TektiteBiz/Tektite-R_EV_Template/README.md

# Tektite-R Electric Vehicle Science Kit
This repository houses the source code and design files for the Tektite-R electric vehicle science kit!

Image of the kit

You can purchase the kit at [our online store](https://tektitebiz.com/product/tektite-r-electric-vehicle-science-kit/).

Find the price analysis and PCB/Schematic files in the Design folder of this repository.

The CAD is on Onshape [here](https://cad.onshape.com/documents/a678383564e9312296f3020b/w/27c2249d7c4797c00d9de45e/e/83639f3ea8453a739e7286b1).
