TektiteBiz/Tektite-R_EV_Template/Design/Pricing.xlsx

Item | Link | Cost | Quantity | Total Cost | Note | Final price--> | $103.91
Black PLA (Frame) | https://www.amazon.com/dp/B0BV24T11D/ | $52.80 | 0.02 | $1.28
ESC (35A XT60) | https://www.aliexpress.us/item/3256806557891003.html | $18.30 | 1.00 | $18.30 | Alternate: https://www.aliexpress.us/item/3256805329452853.html
8x Battery holder | https://www.amazon.com/dp/B07KVHMQRH | $9.34 | 0.50 | $4.67
BaneBots Wheels | https://banebots.com/banebots-wheel-2-x-0-8-hub-mount-40a-orange/ | $74.80 | 0.20 | $14.96
Central shaft (5mm diameter, 100mm long) | https://www.aliexpress.us/item/3256806106856975.html | $0.88 | 1.00 | $0.88
Wheel D shaft (5x138mm) | https://www.aliexpress.us/item/3256806188242363.html | $3.45 | 2.00 | $6.89
Motor (1000kv) | https://www.aliexpress.us/item/2251832679959065.html | $10.05 | 1.00 | $10.05 | The 5.26 in the cost is shipping, but that is once per order
Motor pulley | https://www.aliexpress.us/item/3256805934638435.html | $2.18 | 1.00 | $2.18 | Alternate: https://www.aliexpress.us/item/3256803888885845.html
Long belt pulleys (20T5-60T5, 2GT-280-6) | https://www.aliexpress.us/item/3256804652854836.html | $3.90 | 2.00 | $7.80 | Alternate: https://www.aliexpress.us/item/3256807041239789.html
Short belt pulley (20T5-60T5, 2GT-158-6) | https://www.aliexpress.us/item/3256804652854836.html | $3.81 | 1.00 | $3.81 | Alternate: https://www.aliexpress.us/item/3256802203384432.html and https://www.aliexpress.us/item/2251832693571771.html
Bearing | https://www.aliexpress.us/item/3256806307993875.html | $5.16 | 0.60 | $3.10 | Need 6 bearing, comes in lot of 10, Alternate: https://www.aliexpress.us/item/3256805156145762.html
Quadrature encoder | https://www.aliexpress.us/item/3256804193376739.html | $5.53 | 1.00 | $5.53
Encoder JST connector (PH 2mm, 4P) + Heatshrink | https://www.aliexpress.us/item/3256804650896588.html | $3.03 | 0.20 | $0.61 | Comes in pack of 5
Short screw (M3x6mmm) | https://www.amazon.com/dp/B012TE12CY | $6.59 | 0.17 | $1.12 | Need 17/100 screws
MP screw (M3x12mm) | https://www.amazon.com/dp/B07MHNXPJL | $9.57 | 0.02 | $0.19 | Need 2/100 screws
Button caps | https://www.aliexpress.us/item/2251832666419248.html | $ 5.71 | 0.02 | $ 0.11
Wheel screw (M3x16mm) | https://www.amazon.com/dp/B01BBOZ4JA/ | $8.17 | 0.04 | $0.33 | Need 4/100 screws
Laser pointer | https://www.amazon.com/gp/product/B09NHK7GX9 | $13.19 | 0.17 | $2.20 | Need 1/6 laser pointers
NiCD batteries | https://www.amazon.com/gp/product/B07SG43L9Q/ | $8.80 | 0.00 | $0.00 | NOT INCLUDED WITH KIT
PCB | https://jlcpcb.com | $200.29 | 0.10 | $20.03 | Getting 1 of the 10 in the JLCPCB order
Thank You note | N/A | $0.00 | 1.00 | $0.00
