TektiteBiz/Tektite-R_EV_Template/Design/PCB/BOM_Tektite-R_2024-08-30.csv

ID | Name | Designator | Footprint | Quantity | Manufacturer Part | Manufacturer | Supplier | Supplier Part | Price
1 | 100nF | C3,C4,C5,C7,C10,C11,C13,C16,C18,C19,C20,C21 | C0402 | 12 | CL05B104KO5NNNC | SAMSUNG(三星) | LCSC | C1525 | 0.001
2 | 47nF | C22 | C0603 | 1 | CL10B473KB8NNNC | SAMSUNG(三星) | LCSC | C1622 | 0.004
3 | 150pF | C23 | C0603 | 1 | 0603B151K500NT | FH(风华) | LCSC | C1594 | 0.003
4 | BAT760-7 | D3,D1 | SOD-323_L1.8-W1.3-LS2.5-RD | 2 | BAT760-7 | DIODES(美台) | LCSC | C124187 | 0.038
5 | 15pF | C24 | C0402 | 1 | 0402CG150J500NT | FH(风华) | LCSC | C1548 | 0.001
6 | SS34_C8678 | D2 | SMA_L4.3-W2.6-LS5.2-RD | 1 | SS34 | MDD(辰达半导体) | LCSC | C8678 | 0.025
7 | 3.3uH | L2 | IND-SMD_L7.0-W6.6 | 1 | MWSA0603S-3R3MT | Sunlord(顺络) | LCSC | C408446 | 0.094
8 | 4.7uF | C25 | C1206 | 1 | 1206B475K500NT | FH(风华) | LCSC | C29823 | 0.032
9 | 10uF | C26,C27,C28 | C1206 | 3 | CL31A106KBHNNNE | SAMSUNG(三星) | LCSC | C13585 | 0.032
10 | 100nF | C29,C6 | C0603 | 2 | CC0603KRX7R9BB104 | YAGEO(国巨) | LCSC | C14663 | 0.002
11 | 78.7kΩ | R12 | R0402 | 1 | 0402WGF7872TCE | UNI-ROYAL(厚声) | LCSC | C67239 | 0.001
12 | 13kΩ | R13 | R0603 | 1 | 0603WAF1302T5E | UNI-ROYAL(厚声) | LCSC | C22797 | 0.001
13 | 120kΩ | R14 | R0603 | 1 | 0603WAF1203T5E | UNI-ROYAL(厚声) | LCSC | C25808 | 0.001
14 | 3.65kΩ | R15 | R0402 | 1 | ERJ2RKF3651X | PANASONIC(松下) | LCSC | C416527 | 0.004
15 | TPS55340RTER | U5 | VQFN-16_L3.0-W3.0-P0.50-BL-EP1.7 | 1 | TPS55340RTER | TI(德州仪器) | LCSC | C169167 | 1.182
16 | 150kΩ | R11 | R0603 | 1 | 0603WAF1503T5E | UNI-ROYAL(厚声) | LCSC | C22807 | 0.001
17 | HDR-M-2.54_1x3 | SW,ESC1 | HDR-M-2.54_1X3 | 2 |  |  | LCSC | C180248 | 0.17
18 | 10kΩ | R5 | R0603 | 1 | 0603WAF1002T5E | UNI-ROYAL(厚声) | LCSC | C25804 | 0.001
19 | LMR33630AQRNXRQ1 | U2 | VQFN-12_L3.0-W2.0-P0.65-BL_TI_RNX | 1 | LMR33630AQRNXRQ1 | TI(德州仪器) | LCSC | C1850374
20 | 10uF | C1 | C0805 | 1 | CL21A106KAYNNNE | SAMSUNG(三星) | LCSC | C15850 | 0.01
21 | 220nF | C2 | C0603 | 1 | CL10B224KA8NNNC | SAMSUNG(三星) | LCSC | C21120 | 0.005
22 | 22uF | C4A,C4B,C4C,C4D | C0603 | 4 | CL10A226MQ8NRNC | SAMSUNG(三星) | LCSC | C59461 | 0.008
23 | 1uF | C17 | C0603 | 1 | CL10A105KB8NNNC | SAMSUNG(三星) | LCSC | C15849 | 0.004
24 | 12pF | C8,C9 | C0402 | 2 | 0402CG120J500NT | FH(风华) | LCSC | C1547 | 0.001
25 | 4.7uF | C12,C15 | C0402 | 2 | CL05A475MP5NRNC | SAMSUNG(三星) | LCSC | C23733 | 0.005
26 | 1uF | C14 | C0402 | 1 | CL05A105KA5NQNC | SAMSUNG(三星) | LCSC | C52923 | 0.003
27 | S4B-PH-SM4-TB(LF)(SN) | ENC1,ENC2 | CONN-SMD_S4B-PH-SM4-TB-LF-SN | 2 | S4B-PH-SM4-TB(LF)(SN) | JST | LCSC | C265102 | 0.24
28 | B3F-4055 | GO,STOP | KEY-TH_4P-L12.0-W12.0-P5.00-LS13.4-EH | 2 | B3F-4055 | OMRON(欧姆龙) | LCSC | C84931 | 0.089
29 | 6.8uH | L1 | IND-SMD_L7.0-W6.6 | 1 | FXL0630-6R8-M | cjiang(长江微电) | LCSC | C167221 | 0.17
30 | S2B-PH-SM4-TB(LF)(SN) | M1,M2 | CONN-SMD_P2.00_S2B-PH-SM4-TB-LF-SN | 2 | S2B-PH-SM4-TB(LF)(SN) | JST | LCSC | C295747 | 0.155
31 | 0805G (Green) | PWR | LED0805-R-RD | 1 | KT-0805G | KENTO | LCSC | C2297 | 0.01
32 | 680Ω | R1 | R0603 | 1 | 0603WAF6800T5E | UNI-ROYAL(厚声) | LCSC | C23228 | 0.001
33 | 33Ω | R2,R4 | R0603 | 2 | 0603WAF330JT5E | UNI-ROYAL(厚声) | LCSC | C23140 | 0.001
34 | 47Ω | R3 | R0603 | 1 | 0603WAF470JT5E | UNI-ROYAL(厚声) | LCSC | C23182 | 0.001
35 | 100kΩ | R8 | R0603 | 1 | 0603WAF1003T5E | UNI-ROYAL(厚声) | LCSC | C25803 | 0.001
36 | 43kΩ | R9 | R0603 | 1 | 0603WAF4302T5E | UNI-ROYAL(厚声) | LCSC | C23172 | 0.001
37 | 47kΩ | R10 | R0603 | 1 | 0603WAF4702T5E | UNI-ROYAL(厚声) | LCSC | C25819 | 0.001
38 | 5.1kΩ | R6,R7 | R0402 | 2 | 0402WGF5101TCE | UNI-ROYAL(厚声) | LCSC | C25905 | 0.001
39 | TC5050RGBF08-3CJH-AF53A | RGB | LED-SMD_6P-L5.0-W5.0-TL_TC5050RGBF08 | 1 | TC5050RGBF08-3CJH-AF53A | TCWIN(天成) | LCSC | C784540 | 0.018
40 | HDR-M-2.54_1x4 | SWD | HDR-M-2.54_1X4 | 1 |  |  | LCSC | C124378 | 0.039
41 | STM32F411CEU6 | U1 | UFQFPN-48_L7.0-W7.0-P0.50-BL-EP | 1 | STM32F411CEU6 | ST(意法半导体) | LCSC | C60420 | 2.548
42 | BMI088 | U3 | LGA-16_L4.5-W3.0-P0.50-BL | 1 | BMI088 | Bosch(博世) | LCSC | C194919 | 2.704
43 | DRV8835DSSR | U4 | WSON-12_L3.0-W2.0-P0.50-BL-EP | 1 | DRV8835DSSR | TI(德州仪器) | LCSC | C129328 | 0.946
44 | TYPE-C-31-M-12 | USBC | USB-C_SMD-TYPE-C-31-M-12 | 1 | TYPE-C-31-M-12 | 韩国韩荣 | LCSC | C165948 | 0.161
45 | WJ126V-5.0-2P | VIN | CONN-TH_WJ126V-5.0-2P | 1 | WJ126V-5.0-2P | KANGNEX(康奈克斯电气) | LCSC | C8404 | 0.069
46 | XT60-F | VOUT | CONN-TH_XT60PB-F | 1 | XT60-F | AMASS(艾迈斯) | LCSC | C98734 | 0.272
47 | 25MHz | X1 | OSC-SMD_4P-L3.2-W2.5-BL | 1 | X322525MOB4SI | YXC(扬兴晶振) | LCSC | C9006 | 0.059
48 | TS-1187A-B-A-B | BOOT,RESET | SW-SMD_4P-L5.1-W5.1-P3.70-LS6.5-TL-2 | 2 | TS-1187A-B-A-B | XKB Connectivity(中国星坤) | LCSC | C318884 | 0.017
