TektiteBiz/Tektite-R_EV_Template/Design/PCB/Schematic_Tektite-R_2024-08-30.pdf

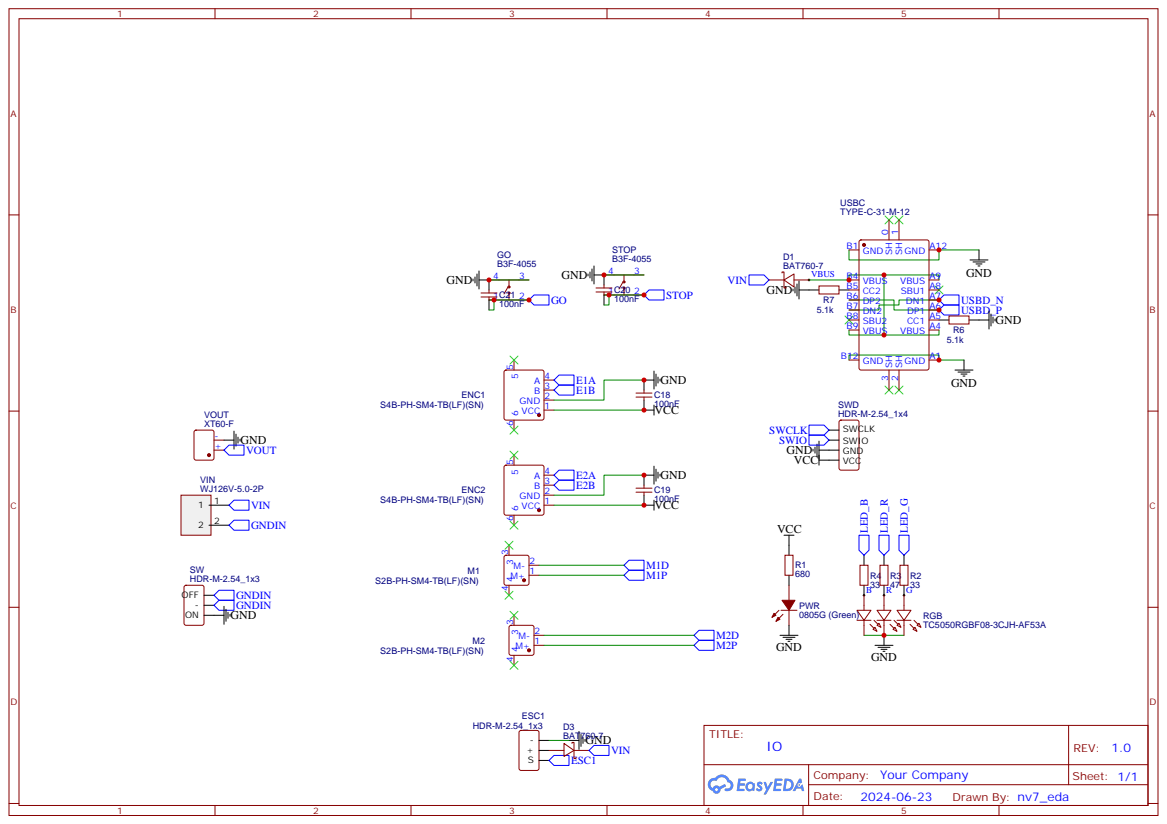
[picture p1: page 1]

# PB1 19 PB2 20 PB3 39 PB4 40 PB5 41 PB6 42 PB7 43

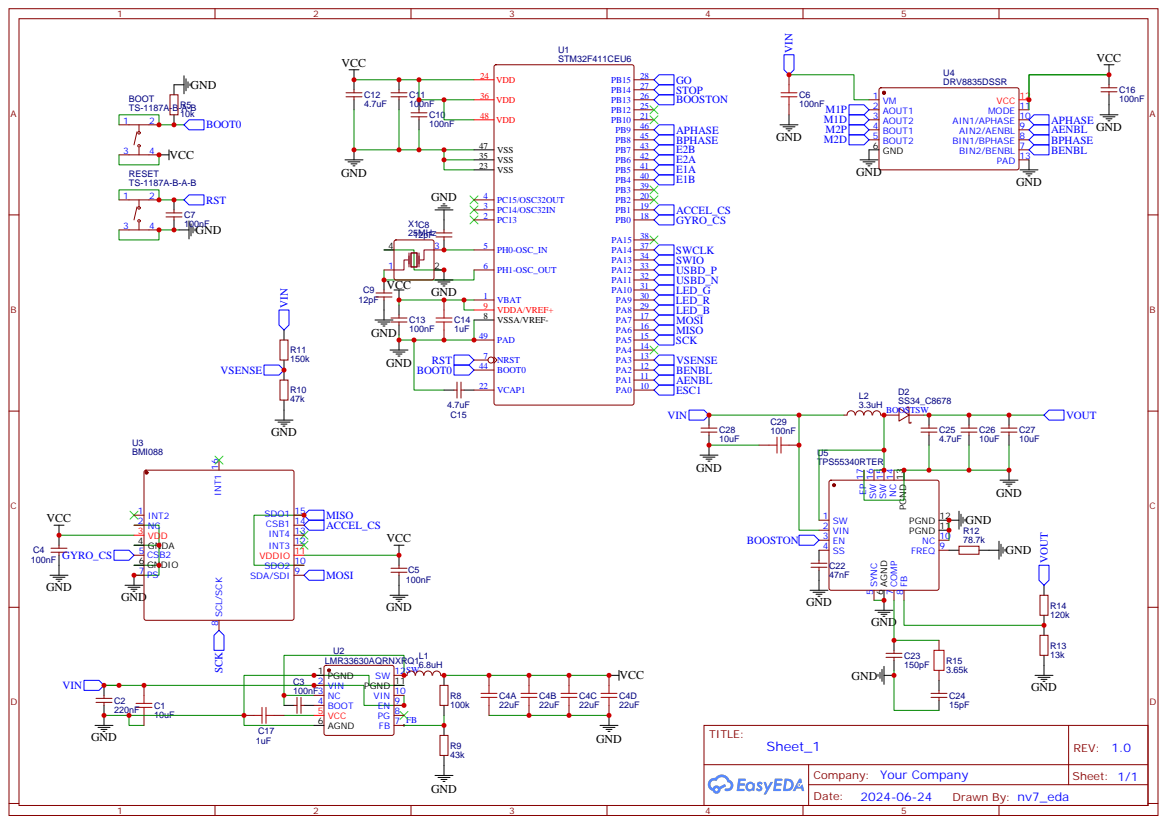
[picture p2: page 2]
