TektiteBiz/Tektite-R_EV_Template/Core/Src/main.c

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
/* Includes ------------------------------------------------------------------*/
#include "main.h"
#include "adc.h"
#include "spi.h"
#include "tim.h"
#include "usb_device.h"
#include "gpio.h"

/* USER CODE BEGIN Includes */
#include "peripheral.h"
#include "control.h"
/* USER CODE END Includes */

/* USER CODE BEGIN PTD */
extern uint8_t CDC_Transmit_FS(uint8_t* Buf, uint16_t Len);
/* USER CODE END PTD */


void SystemClock_Config(void);
/**
  * @brief  The application entry point.
  * @retval int
  */
int main(void)
{

  /* MCU Configuration--------------------------------------------------------*/

  /* Reset of all peripherals, Initializes the Flash interface and the Systick. */
  HAL_Init();

  /* Configure the system clock */
  SystemClock_Config();

  /* Initialize all configured peripherals */
  MX_GPIO_Init();
  MX_SPI1_Init();
  MX_USB_DEVICE_Init();
  MX_TIM2_Init();
  MX_TIM1_Init();
  MX_ADC1_Init();
  MX_TIM3_Init();
  MX_TIM4_Init();
  /* USER CODE BEGIN 2 */
  PeripheralInit();
  DataInit();

  LEDWrite(255, 255, 255);
  ESCWrite(0);
  HAL_Delay(500);


  float battVoltage = BattVoltage();
  /* USER CODE END 2 */

  /* Infinite loop */
  /* USER CODE BEGIN WHILE */
  while (1)
  {
    /* USER CODE END WHILE */

    /* USER CODE BEGIN 3 */
	LEDWrite(0, 0, 0);
	ESCWrite(1.5);
	HAL_GPIO_WritePin(BOOSTON_GPIO_Port, BOOSTON_Pin, GPIO_PIN_RESET);

	if (battVoltage < 5.1) { // USB Power
		LEDWrite(64, 64, 64);
		//printf("%f\n", BattVoltage());
	} else if (GOPressed()) {
	  Go();
	}

	if (battVoltage < 10.0) { // Time to charge!
		LEDWrite(128, 64, 0);
	}

	while (STOPPressed()) {
	  LEDWrite(255, 0, 0);
	}

	if (dataAvailable) {
	  DataAvailable();
	}
  }
  /* USER CODE END 3 */
}

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
/* USER CODE BEGIN 4 */
/**
  * @brief  Retargets the C library printf function to the USART.
  * @PAram  None
  * @retval None
  */
int _write(int file, char *ptr, int len) {
    CDC_Transmit_FS((uint8_t*) ptr, len); return len;
}
/* USER CODE END 4 */
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
