TektiteBiz/Tektite-R_EV_Template/Tektite-R_EV_Template.ioc

Mcu.UserName=STM32F411CEUx
PA0-WKUP.GPIO_Label=ESC1
PA0-WKUP.Signal=S_TIM2_CH1_ETR
PA10.GPIO_Label=LED_G
PA10.Signal=S_TIM1_CH3
PA11.Signal=USB_OTG_FS_DM
PA12.Signal=USB_OTG_FS_DP
PA13.Signal=SYS_JTMS-SWDIO
PA14.Signal=SYS_JTCK-SWCLK
PA3.GPIO_Label=VSENSE
PA3.Signal=ADCx_IN3
PA5.Signal=SPI1_SCK
PA6.Signal=SPI1_MISO
PA7.Signal=SPI1_MOSI
PA8.GPIO_Label=LED_B
PA8.Signal=S_TIM1_CH1
PA9.GPIO_Label=LED_R
PA9.Signal=S_TIM1_CH2
PB0.GPIO_Label=GYRO_CS
PB0.Signal=GPIO_Output
PB1.GPIO_Label=ACCEL_CS
PB1.Signal=GPIO_Output
PB13.GPIO_Label=BOOSTON
PB13.Signal=GPIO_Output
PB14.GPIO_Label=STOP
PB14.Signal=GPIO_Input
PB15.GPIO_Label=GO
PB15.Signal=GPIO_Input
PB4.GPIO_Label=E1B
PB4.Signal=S_TIM3_CH1
PB5.GPIO_Label=E1A
PB5.Signal=S_TIM3_CH2
PB6.GPIO_Label=E2A
PB6.Signal=S_TIM4_CH1
PB7.GPIO_Label=E2B
PB7.Signal=S_TIM4_CH2
