TektiteBiz/Tektite-R_EV_Template/Core/Inc/main.h

#define ESC1_Pin GPIO_PIN_0
#define ESC1_GPIO_Port GPIOA
#define VSENSE_Pin GPIO_PIN_3
#define VSENSE_GPIO_Port GPIOA
#define GYRO_CS_Pin GPIO_PIN_0
#define GYRO_CS_GPIO_Port GPIOB
#define ACCEL_CS_Pin GPIO_PIN_1
#define ACCEL_CS_GPIO_Port GPIOB
#define BOOSTON_Pin GPIO_PIN_13
#define BOOSTON_GPIO_Port GPIOB
#define STOP_Pin GPIO_PIN_14
#define STOP_GPIO_Port GPIOB
#define GO_Pin GPIO_PIN_15
#define GO_GPIO_Port GPIOB
#define LED_B_Pin GPIO_PIN_8
#define LED_B_GPIO_Port GPIOA
#define LED_R_Pin GPIO_PIN_9
#define LED_R_GPIO_Port GPIOA
#define LED_G_Pin GPIO_PIN_10
#define LED_G_GPIO_Port GPIOA
#define E1B_Pin GPIO_PIN_4
#define E1B_GPIO_Port GPIOB
#define E1A_Pin GPIO_PIN_5
#define E1A_GPIO_Port GPIOB
#define E2A_Pin GPIO_PIN_6
#define E2A_GPIO_Port GPIOB
#define E2B_Pin GPIO_PIN_7
#define E2B_GPIO_Port GPIOB
