TektiteBiz/Tektite-R_EV_Template/(commit log)

2024-08-15 Add booston pin
2024-08-23 Add design files and README
    [BOM_Tektite-R_2024-08-23.csv, PickAndPlace_PCB_Tektite-R_2024-08-23.csv, Pricing.xlsx]
2024-08-23 Fix power coming in from ESC, add battery charging LED
    [BOM_Tektite-R_2024-08-23.csv, PickAndPlace_PCB_Tektite-R_2024-08-23.csv]
2024-08-31 Tektite-R 0.3.1
    [BOM_Tektite-R_2024-08-23.csv, BOM_Tektite-R_2024-08-30.csv, PickAndPlace_PCB_Tektite-R_2024-08-23.csv, PickAndPlace_PCB_Tektite-R_2024-08-30.csv]
2024-08-31 Update pricing for new pulley
    [Pricing.xlsx]
2024-09-12 Update pricing with real-world orders
    [Pricing.xlsx]
2024-09-22 Update pricing and remove debug print
    [Pricing.xlsx]
2024-11-05 Update pricing, make text more reliable
    [Pricing.xlsx]
